aspirantee24bt017/2025-eYRC-KB-2155-Balancing-Bot/STAB-E_poster (1).pdf

D6(PWM) | ENA- Left Motor Speed
A2 | IN1 - Left Motor Dir
A3 | IN2 - Left Motor Dir
D5(PWM) | ENB- Right Motor Speed
D9 | IN3 - Right Motor Dir
D4 | IN4 - Right Motor Dir

## PROJECT OVERVIEW

Chassis | 3-layer MDF (laser-cut)
Wheel diameter | 43 mm
Wheel base | ~100 mm
Drive motors | 2× N20 300 RPM DC gear motors
Encoder resolution | ~6170 ticks / revolution
Arm | Blue PLA 3D-printed, 2× TowerPro MG90S servos

## ROBOT AT A GLANCE

Total weight (est.) | ~350 g
LEFT VIEW | RIGHT VIEW | TOP VIEW

Microcontroller

Arduino Nano
(ATmega328P)
IMU | MPU6050 (GY-521 module)
Motor driver | L298N dual H-bridge
Power | 7.4 V 2S LiPo, ~1200 mAh
Bluetooth | HC-05 module
Servo | TowerPro MG90S × 2

Complementary Filter
(9 - Pitch Imgin)

θ[n] = 0.96 × (θ[n-1] + ω[n] × dt) +0.04 × θ_acc

FRONT VIEW | BACK VIEW

Why Complementary Filter?

## PID Tuning Results

Self balancing robot based inverted pendulum principle

Built for eYRC robotics
competition , hosted by
IIT Bombay.

Capabilities :
a.balancing in one place
b.Manipulator arm for
payload tasks
c.wireless connection
d.3.5 - 4 hrs of battery life

Gyro - Short-term accuracy. Accelerometer - long-term stability. Cutoff Frequency = 0.637Hz. Efficient, Reliable and drift resistant.

## HARDWARE SPECIFICATION

Final PID Gains

IMU Details
MPU6050 (16-bit ADC)
Gyro Range: ±2000°/s
Accel Range: ±8g
12C Speed: 400KHz
Sampling Rate: 100HZ
Controller | Kp | Ki | Kd | Rate
Angle(Inner) Velocity (Outer) Yaw(PI) | 45.0
| 0.025
| 1.5 | 0.0
| | 0.01
| | 0.3 | 0.8
| | | - | 100Hz
| | | | 20Hz
| | | | 20Hz

Highlights
System remains stable even with arm inertia.

Kd increased from 0.5 to 0.8 to handle extra load.

Zero steady-state error in tilt and yaw.

Tuning using Ziegler-Nichols, then refined
manually for real-world stability

Your paragraph text

# Team ID : KB#2155 Semi-Finalist (Stage 2)

## CONTROL ARCHITECTURE

Key Decisions :
1. D-term uses raw gyro rate (not differentiated angle)
2. Outer loop outputs an angle offset, not direct PWM
3. Yaw uses gyro gz, not encoders
4. I2C at 400 kHz (Fast Mode)

## SENSOR FUSION

## TEAM MEMBER

## Prathamesh Nerpagar Btech EEE,IIT Dharwad

## Roll no : EE24BT017

### Email :ee24bt017@iitdh.ac.in

## ELECTRICAL CONNECTIONS

Pin Map (Arduino Nano) | Peripherals

Motor Driver (L298N)

Encoders

D2 | Left Encoder A | (INT0 -Reliable)
D3 | Left Encoder B | (INT1 -Reliable)
D7 | Left Encoder A (PCINT -Unreliable)
D8 | Left Encoder B (PCINT -Unreliable)

# ⚠️Right encoder PCINT issue: At N20 motor speed (~300 RPM × gear ratio), PCINT interrupts

miss ~96% of pulses due to timing conflicts with the PWM timer. Yaw is controlled via gyro

_gz
instead.

A4 (SDA) MPU6050 SDA
A5 (SCL) MPU6050 SCL
A1 | BUZZER
A0 | Servo(Arm)
D12(Rx) | HC-05 TX ->nano RX
D13(Tx) | HC-05 TX ->nano TX
Note :

HC-05 moved to pins 12/13 to avoid PCINT conflict with encoders.
Right motor polarity inverted on chassis → handled in firmware.
baseTargetAngle = -1.1° compensates for CoG offset.

# STAB-E

## CALIBRATIONS -Key Procedures

Encoder Calibration | Motor Calibration
STARTUP -Key Procedures Documentation and Source code | TASK SUMMARY

(Self-balancing Two-wheel ARM Bot Entity) Cascaded PID control with manipulator Arm for Agirculture Automation

## Designed for stability, precision control, and autonomous mobile manipulation

Full source code, Arduino firmware, CoppeliaSim simulation &
circuit documentation. Cascaded PID | Startup guide
Demo Vedio (Harware and Simulation) Team KB#2155 — eYRC 2025-26, IIT Bombay.
Scan QR to access Repository Contents | Task 1 —

Simulation: Basic Balancing (CoppeliaSim)
Implemented complementary filter and inner angle PID loop in Pythob.. Robot balances in place with no external disturbances.

Task 2 —
Simulation: Motion Control (Webots)
Added outer velocity loop and yaw control. Robot responds to keyboard commands — forward, backward, and turn in simulation.

Task 3 —
Hardware: Full Balancing Demo, All three control loops running on Arduino Nano hardware. Robot balances, carries payload using the servo arm, and recovers from pushes.
Hardware Implementation | Simulation

## APPLICATIONS & PURPOSE

- Design a stable two-wheeled robot using cascaded PID
- Integrate balancing with manipulation
- Develop an efficient embedded control system
- Ensure robust real-world performance

Application

Agricultural Automation
Robots
Terrain Balancing Platforms Mobiile manipulation
Systems
Purpose | Gyro Calibration

Place robot on flat surface (still).
Wait for single beep → calibration starts. Do NOT move robot (~4 seconds). Offsets stored: gyro

_

offset & gyro

_

offset

_

z.

Rotate output shaft exactly one full turn.
Count / 4 = Encoder CPR.
CPR × Gear Ratio = TICKS_PER_REV. Current Value: ~6170 ticks/rev

Run each motor at PWM = 100. Measure RPM / ticks per second. scale = ref

_

velocity / measured_velocity. Update leftMotorScale / rightMotorScale.
